Achraf-ElAmrani/Gamboy_Achraf_2024/README.md

# Console de jeux portable
      

# Projet en cours de réalisation par : 
- **Nom,Prénom :** El Amrani, Achraf
- **Ecole :** étudiant a l' INRACI
- **Année :** 6 ème Technique de qualification
- **Promoteur :** Mr Feliz Kapita 
## Video
## Sommaire
- [Introduction](#Introduction)
- [Liste des composants](#Liste-des-composants)
- [Les caractéristiques](#Les-caractéristiques)
- [Schéma de principe](#Schéma-de-principe)
- [le PCB](#le-PCB)
- [Schéma de bloc](#Le-schéma-bloc)
- [Ordinogramme](#Ordinogramme)
- [3D](#3D)
- [Bibliothèques nécessaires](#Bibliothèques-nécessaires)
- [Source](#Source)
## Introduction

Passionné par les jeux vidéo, j’ai décidé de consacrer mon projet de fin d’études à la création d’une console de jeux portable. L’inspiration m’est venue après avoir découvert le film Tetris, qui met en lumière le célèbre jeu ainsi que la mythique Game Boy.

Mon objectif est de concevoir un appareil capable d’exécuter plusieurs jeux, avec Tetris comme titre principal. L’expérience de jeu sera optimisée grâce à un système de contrôle intuitif, combinant joystick et boutons physiques.

Ce projet est bien plus qu’un simple exercice technique : il représente l’aboutissement de mon parcours académique et l’opportunité d’appliquer concrètement les compétences que j’ai développées au fil des années. Il reflète mon engagement dans le domaine de l'électronique et du jeu vidéo ainsi que mon envie de relever des défis techniques stimulants.

## Liste des composants

- Un micro controleur feather / Feather M0 express

- un  expandeur d'E/S (Entrées/Sorties) / MCP23008

- Un écran SPI / ILI9341 TFT 2.8"

- Un régulateur de tension linéaire LDO (Low Dropout) / MCP1826

- Un amplificateur audio de classe D / MAX98357A 

- Un contrôleur de charge pour batterie Li-Ion/Li-Po / MCP73831T-2ACI/OT

- Un  Mini Joystick Analogique 2 Axes / Joystick 2765

- Une double batterie Li-Ion

- x4 boutons

- x8 Résistances

- x1 condosateur 

- x1 LED 

- x3 diode

## Les caractéristiques
**Feather M0 express :** 

- Microcontrôleur : ATSAMD21G18 (32 bits)

- Fréquence : 48 MHz

- Mémoire Flash : 256 KB

- RAM : 32 KB

- Stockage : 2 Mo de SPI Flash intégré 

- Alimentation : via USB ou batterie Li-Po 3.7V 

- Ports I/O : 20 GPIO (dont 6 analogiques, PWM et I²C/SPI/UART)

- Sortie DAC 10 bits (1 broche analogique vraie)

- Connectivité : I²C, SPI, UART, PWM

- Compatible avec : Arduino IDE

**MCP23008 :**

- 8 broches d'E/S configurables individuellement en entrée ou sortie

- Communication via I²C (adresse configurable)

- Résistances de tirage (pull-up) intégrées (100 kΩ activables par logiciel)

- Interruption configurable (INT) pour détecter les changements d'état des broches

- Tension de fonctionnement : 1.8V à 5.5V

- Courant max par broche : environ 25mA (selon la tension)

**MCP1826 :**

- Tension d’entrée (Vin) : 2.1V à 13.2V

- Tension de sortie (Vout) : 5V 

- Courant de sortie max : 1A

- Faible chute de tension (Dropout) : ~0.525V 

- Faible consommation de courant : 120 µA

**MAX98357A :**

- Entrée audio numérique : I²S (compatible standard 16, 24 et 32 bits)

- Sortie audio : Mono, puissance jusqu'à 3,2W sous 4Ω (avec une alimentation de 5V)

- Plage d’alimentation : 2.5V à 5.5V

- Convertisseur DAC + amplificateur intégré

- Faible consommation et haute efficacité 

- Filtrage interne pour réduire le bruit et améliorer la qualité sonore

- Fonctionne avec l'horloge interne du microcontrôleur

**MCP73831T-2ACI/OT :**

- Tension d’entrée (Vin) : 3.75V à 6V

- Courant de charge max : 500 mA 

- Tension de charge : 4.2V (pour batteries Li-Ion / Li-Po)

- Faible consommation en veille

- Indicateur LED possible : indique l’état de charge (via la broche STAT)

**Joystick 2765 :**

- Type : Joystick analogique auto-centrant à 2 axes.

- Potentiomètres intégrés : Deux potentiomètres de 10 kΩ chacun, un pour l'axe vertical (haut/bas) et un pour l'axe horizontal (gauche/droite).

**ILI9341 TFT 2.8" :**

- Taille : 2.8 pouces

- Résolution : 240x320 pixels (orientation portrait ou paysage)

- Couleurs : 65K ou 262K couleurs (16 ou 18 bits)

- Tension d’alimentation : 3.3V 

- Tactile en option :  écran tactile résistif 

- Fréquence SPI : Jusqu’à 40MHz, permettant un affichage fluide

- Rétroéclairage LED intégré
  
**méchanique :**

- Poid : +-200

- Taille : 150 x 180 mm

- Materiaux : PLA noire

## Schéma de principe
Schematic_tfe new pcb_2025-05-25

## le PCB

PCB_PCB_tfe new pcb_2025-05-25
PCB_PCB_tfe new pcb_2025-05-25 blue
PCB_PCB_tfe new pcb_2025-05-25 red

## Le schéma bloc
schema bloque drawio (2) (1)

## Ordinogramme
Diagramme sans nom drawio

## 3D 
Capture d'écran 2025-02-04 203529
Capture d'écran 2025-02-04 194054
Capture d'écran 2025-02-04 194103
Capture d'écran 2025-02-04 194122

## Bibliothèques nécessaires
- **Adafruit GFX Library :** https://github.com/adafruit/Adafruit-GFX-Library
- **Adafruit ILI9341 :** https://github.com/adafruit/Adafruit_ILI9341
- **Adafruit MCP23008 library :** https://github.com/adafruit/Adafruit-MCP23008-library
## Source 
- **Adafruit MAX98357 I2S Class-D Mono Amp (25/05/2025) :** Downloads | Adafruit MAX98357 I2S Class-D Mono Amp | Adafruit Learning System
- **I2S (25/05/2025) :** I2S — Wikipédia
- **MAX98357A Class D'Amplifier (25/05/2025) :** https://youtu.be/At8PDQ3g7FQ
- **Max98357 - What is I2S ?** https://www.az-delivery.de/en/blogs/azdelivery-blog-fur-arduino-und-raspberrypi/max98357-was-ist-eigentlich-i2s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 
## Datasheet
- **ADAFRUIT USB C BREAKOUT BOARD :** [https://mm.digikey.com/Volume0/opasdata/d220001/medias/docus/320/4090_Web.pdf](https://mm.digikey.com/Volume0/opasdata/d220001/medias/docus/320/4090_Web.pdf) 
- **FEATHER 32U4 BASIC PROTO ATMEGA :** [ https://cdn-learn.adafruit.com/downloads/pdf/adafruit-feather-32u4-basic-proto.pdf](https://cdn-learn.adafruit.com/downloads/pdf/adafruit-feather-32u4-basic-proto.pdf)
- **MCP73831/2 :** [https://ww1.microchip.com/downloads/en/DeviceDoc/MCP73831-Family-Data-SheetDS20001984H.pdf ](https://ww1.microchip.com/downloads/en/DeviceDoc/MCP73831-Family-Data-Sheet-DS20001984H.pdf)
- **MINI 2-AXIS ANALOG THUMBSTICK :** https://mm.digikey.com/Volume0/opasdata/d220001/medias/docus/813/2765_Web.pdf
- **MCP1826 :** https://ww1.microchip.com/downloads/en/DeviceDoc/22057B.pdf
- **MAX98357A :** https://cdn-shop.adafruit.com/product-files/3006/MAX98357A-MAX98357B.pdf
- **MCP23008 :** https://ww1.microchip.com/downloads/en/DeviceDoc/MCP23008-MCP23S08-Data-Sheet-20001919F.pdf
