Achraf-ElAmrani/Gamboy_Achraf_2024/(commit log)

2025-02-20 modification de la structure du dossier
2025-02-22 commit 3
    suppressions des éléments inutiles et simplification de certaines lignes.
2025-02-22 commit 4
    Ajout de la libraire MCP008 et define des des BP
2025-03-01 Point au centre avec appuie du BP1
    -ajout des broches des BP
    - lorsque le BP1 est pressé le point reviens au centre
    -problème le joystick ne fonctionne plus lors quand je rajoute se bout de code
2025-03-01 ajout du niveau electrique
    -le joystick refonctionne mais n'est pas fluide
    -les bouton ne réalise pas se que je demande
2025-03-08 ajout d'un menu avec choix
    -Rajout du menu ou se trouveront les jeux
    -point
    -space invaders
2025-03-12 fonction
    -établissement des fonctions et restructuration du code
2025-03-12 fonction suite
    -Rajout de valeur de sortie mais sans valeur de d'entrée
2025-03-12 fonction s et 1 entrée
    -valeur de sortie et au moins une valeur d'entrée
2025-03-18 millis
    -remplacement des delay par millis
2025-03-31 ajout d'image
    ajout d'image dans PCB et schema de prcp
2025-03-31 librairie
    rajout de 3 librairie
2025-04-03 correction
    correction de l'orthographe
2025-05-17 space_invaders+refresh
    -ajout du jeu space invaders
    -methode de rafraichissement
2025-05-27 readme+code
    -ajout de texte dans le code
    -ajout du TFE
2025-06-09 Mofication essentiel
    -ajout d un mode librairie
    -ajout du son(musique)
    -commentaire expliquant certaine chose
    -J'ai mal au crane a cause des calculs de delta
2025-06-09 ajout et retirage
    -simplification du code a certain point
    -retrait d'élément inutile comme millis
    -ajout de commentaire
    -ctrl +t pour ordonné le code
    -il est 2h du matin j'ai envie de me foutre en l'air
